wallComputer/STM32G4_PCB_V2/README.md

# STM32G4_PCB_V2
 Breakout Board for STM32G431CBU6
