wallComputer/STM32G4_PCB_V2/projectLibs/crystal_3215_STEP/NX3215SA.step

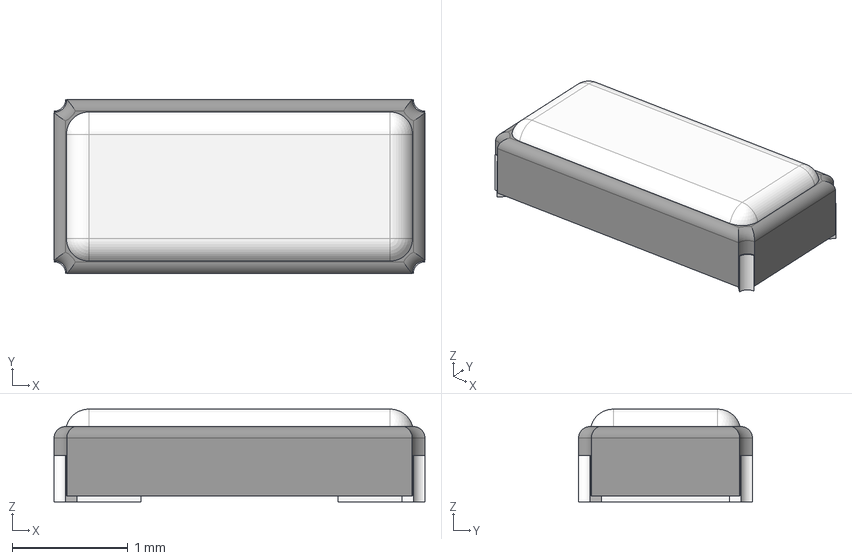
[picture p1: CAD file, 2022-04-19]
projectLibs/crystal_3215_STEP/NX3215SA.step
3.20 x 1.50 x 0.8 mm
