wallComputer/STM32G4_PCB_V2/projectLibs/TS-1187A-B-A-B/TS-1187A-B-A-B--3DModel-STEP-56544.STEP

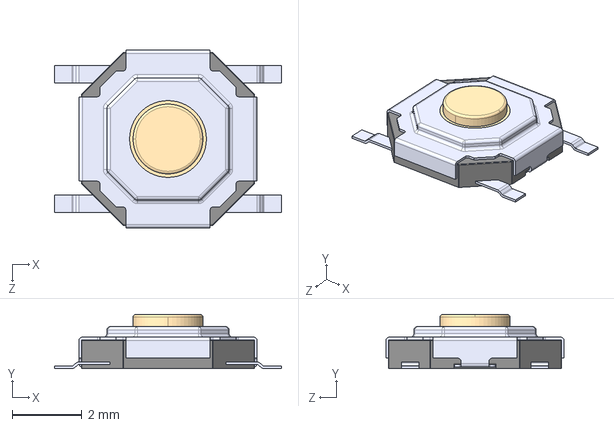
[picture p2: CAD file, 2022-04-19]
projectLibs/TS-1187A-B-A-B/TS-1187A-B-A-B--3DModel-STEP-56544.STEP
6.50 x 1.55 x 5.10 mm
