wallComputer/STM32G4_PCB_V2/projectLibs/TYPE-C-31-M-12/TYPE-C-31-M-12.step

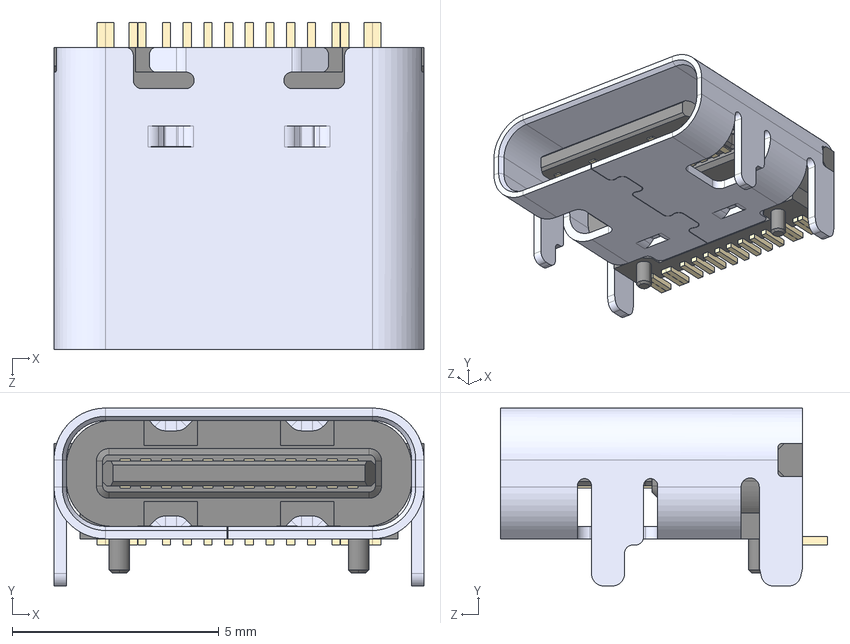
[picture p3: CAD file, 2022-04-19]
projectLibs/TYPE-C-31-M-12/TYPE-C-31-M-12.step
8.94 x 4.30 x 7.90 mm
