wallComputer/STM32G4_PCB_V2/projectLibs/ul_STM32G431CBU6/2022-04-16_14-02-51/STEP/UFQFPN-48_7X7X0P55MM.step

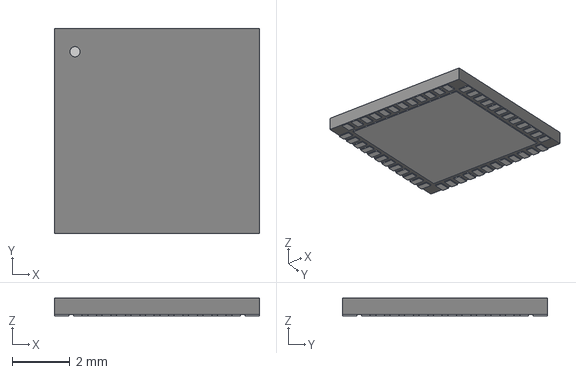
[picture p4: CAD file, 2022-04-19]
projectLibs/ul_STM32G431CBU6/2022-04-16_14-02-51/STEP/UFQFPN-48_7X7X0P55MM.step
7.11 x 7.11 x 0.612 mm
