wallComputer/STM32G4_PCB_V2/projectLibs/MOLEX_473460001/47346-0001.step

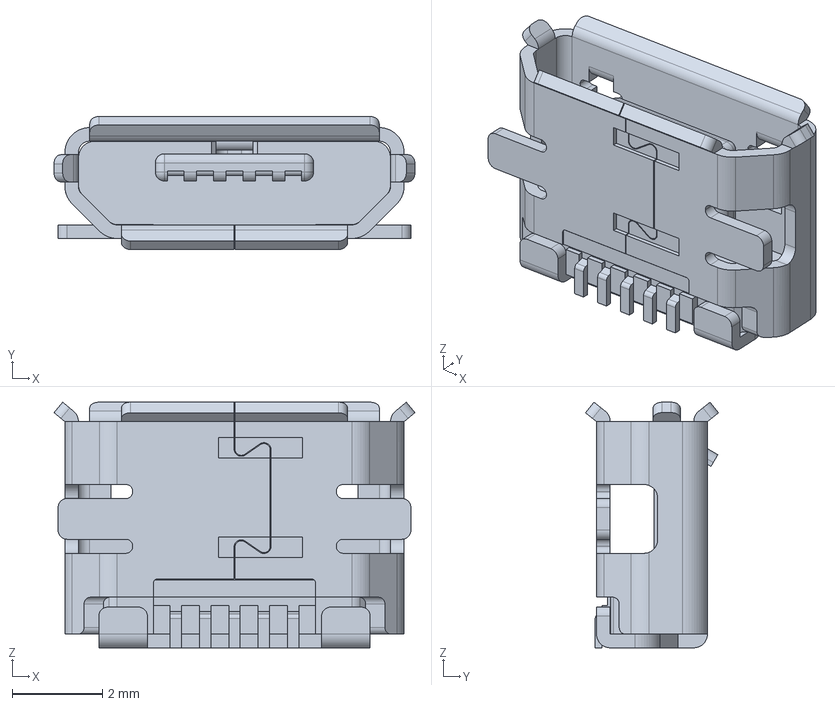
[picture p5: CAD file, 2022-04-19]
projectLibs/MOLEX_473460001/47346-0001.step
7.98 x 2.94 x 5.43 mm
