wallComputer/STM32G4_PCB_V2/STM32G4_PCB.pdf

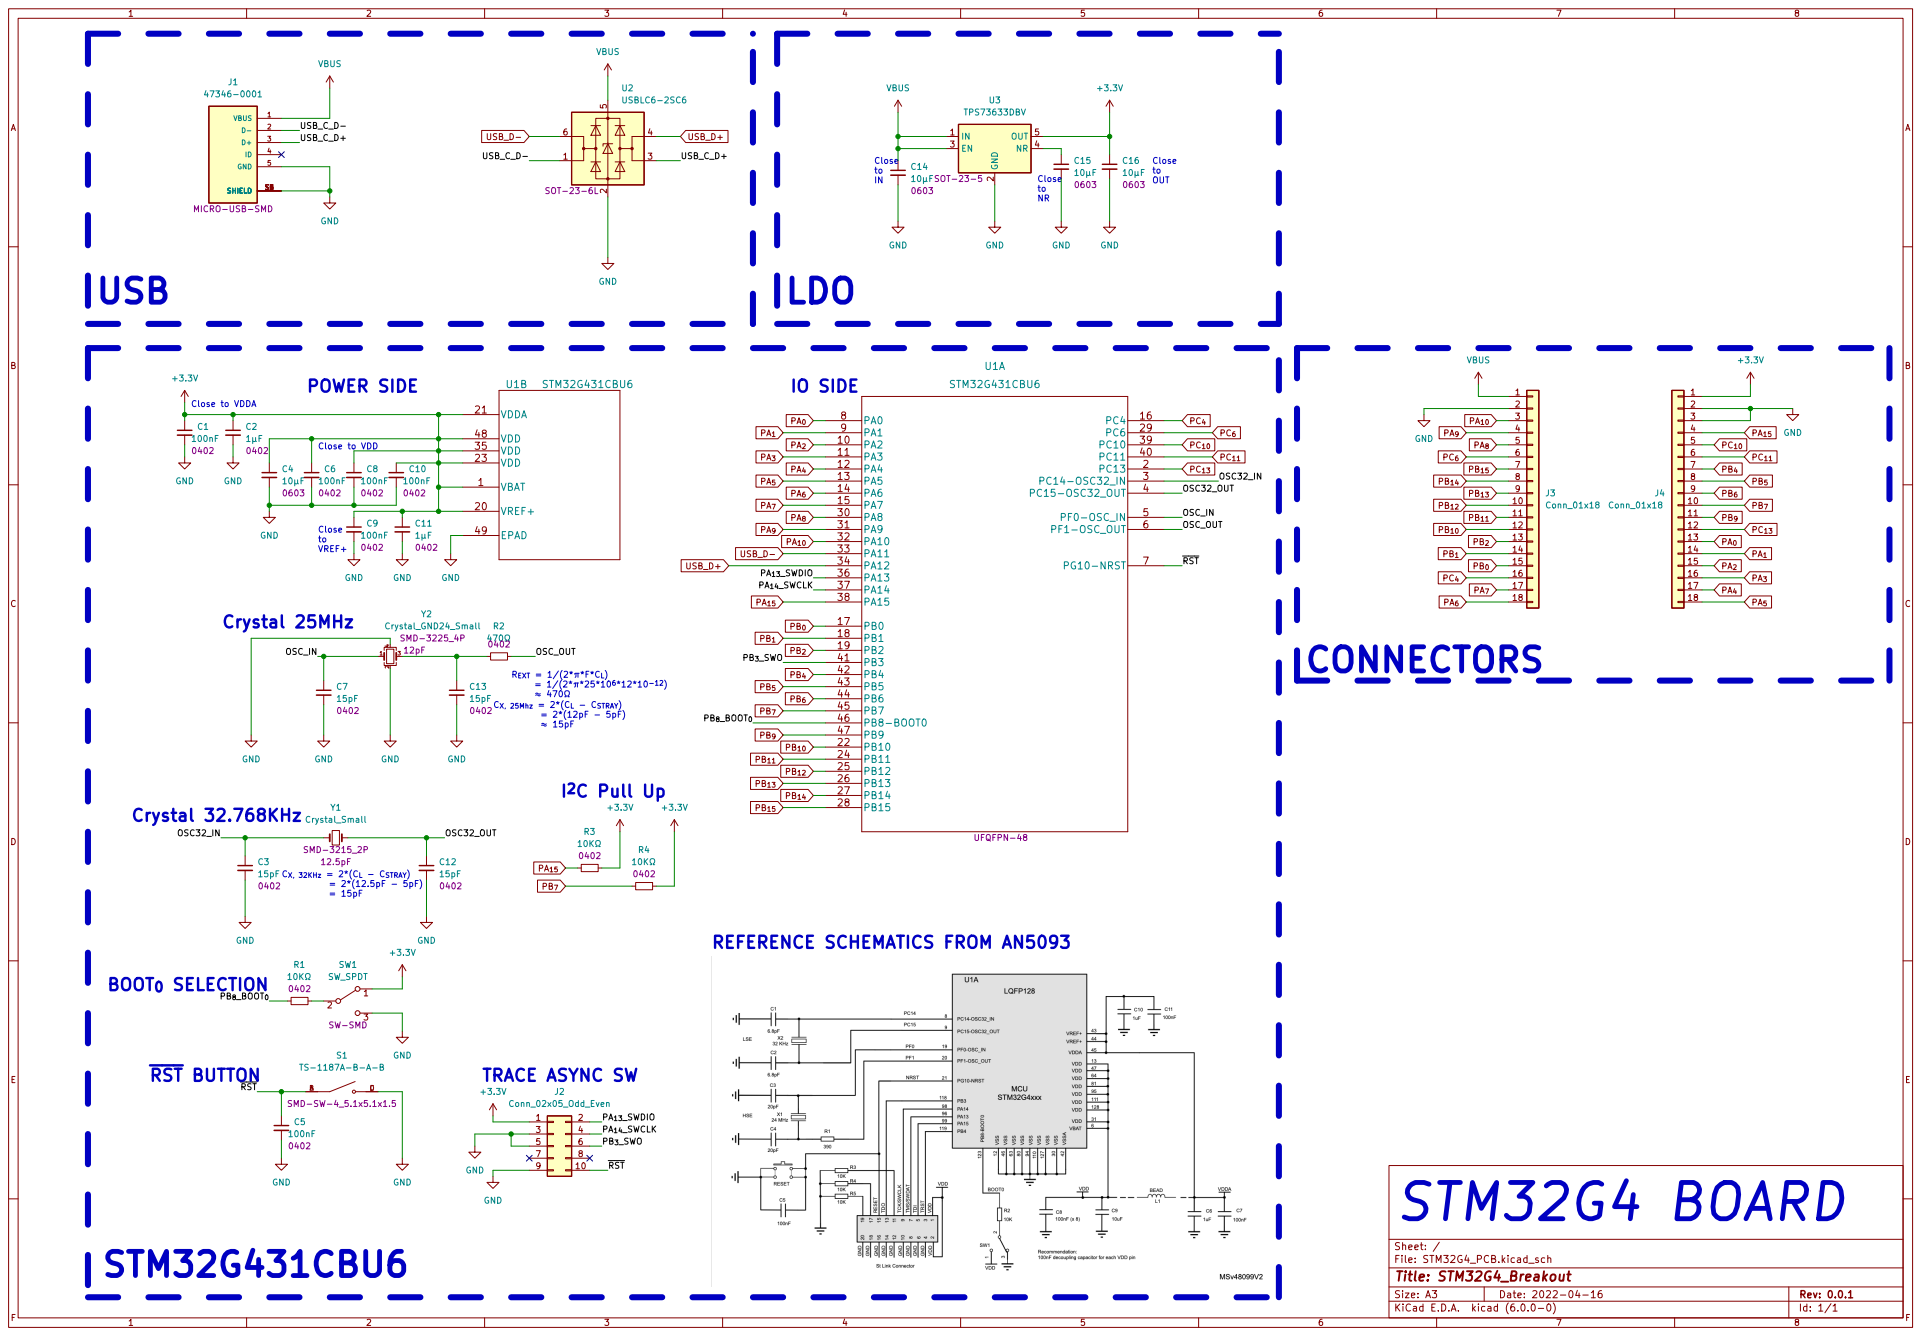
[picture p6: page 1]

toOUT Close to VDD
