wallComputer/STM32G4_PCB_V2/STM32G4_PCB.kicad_pcb

## KiCad design STM32G4_PCB.kicad_pcb (2022-04-19)

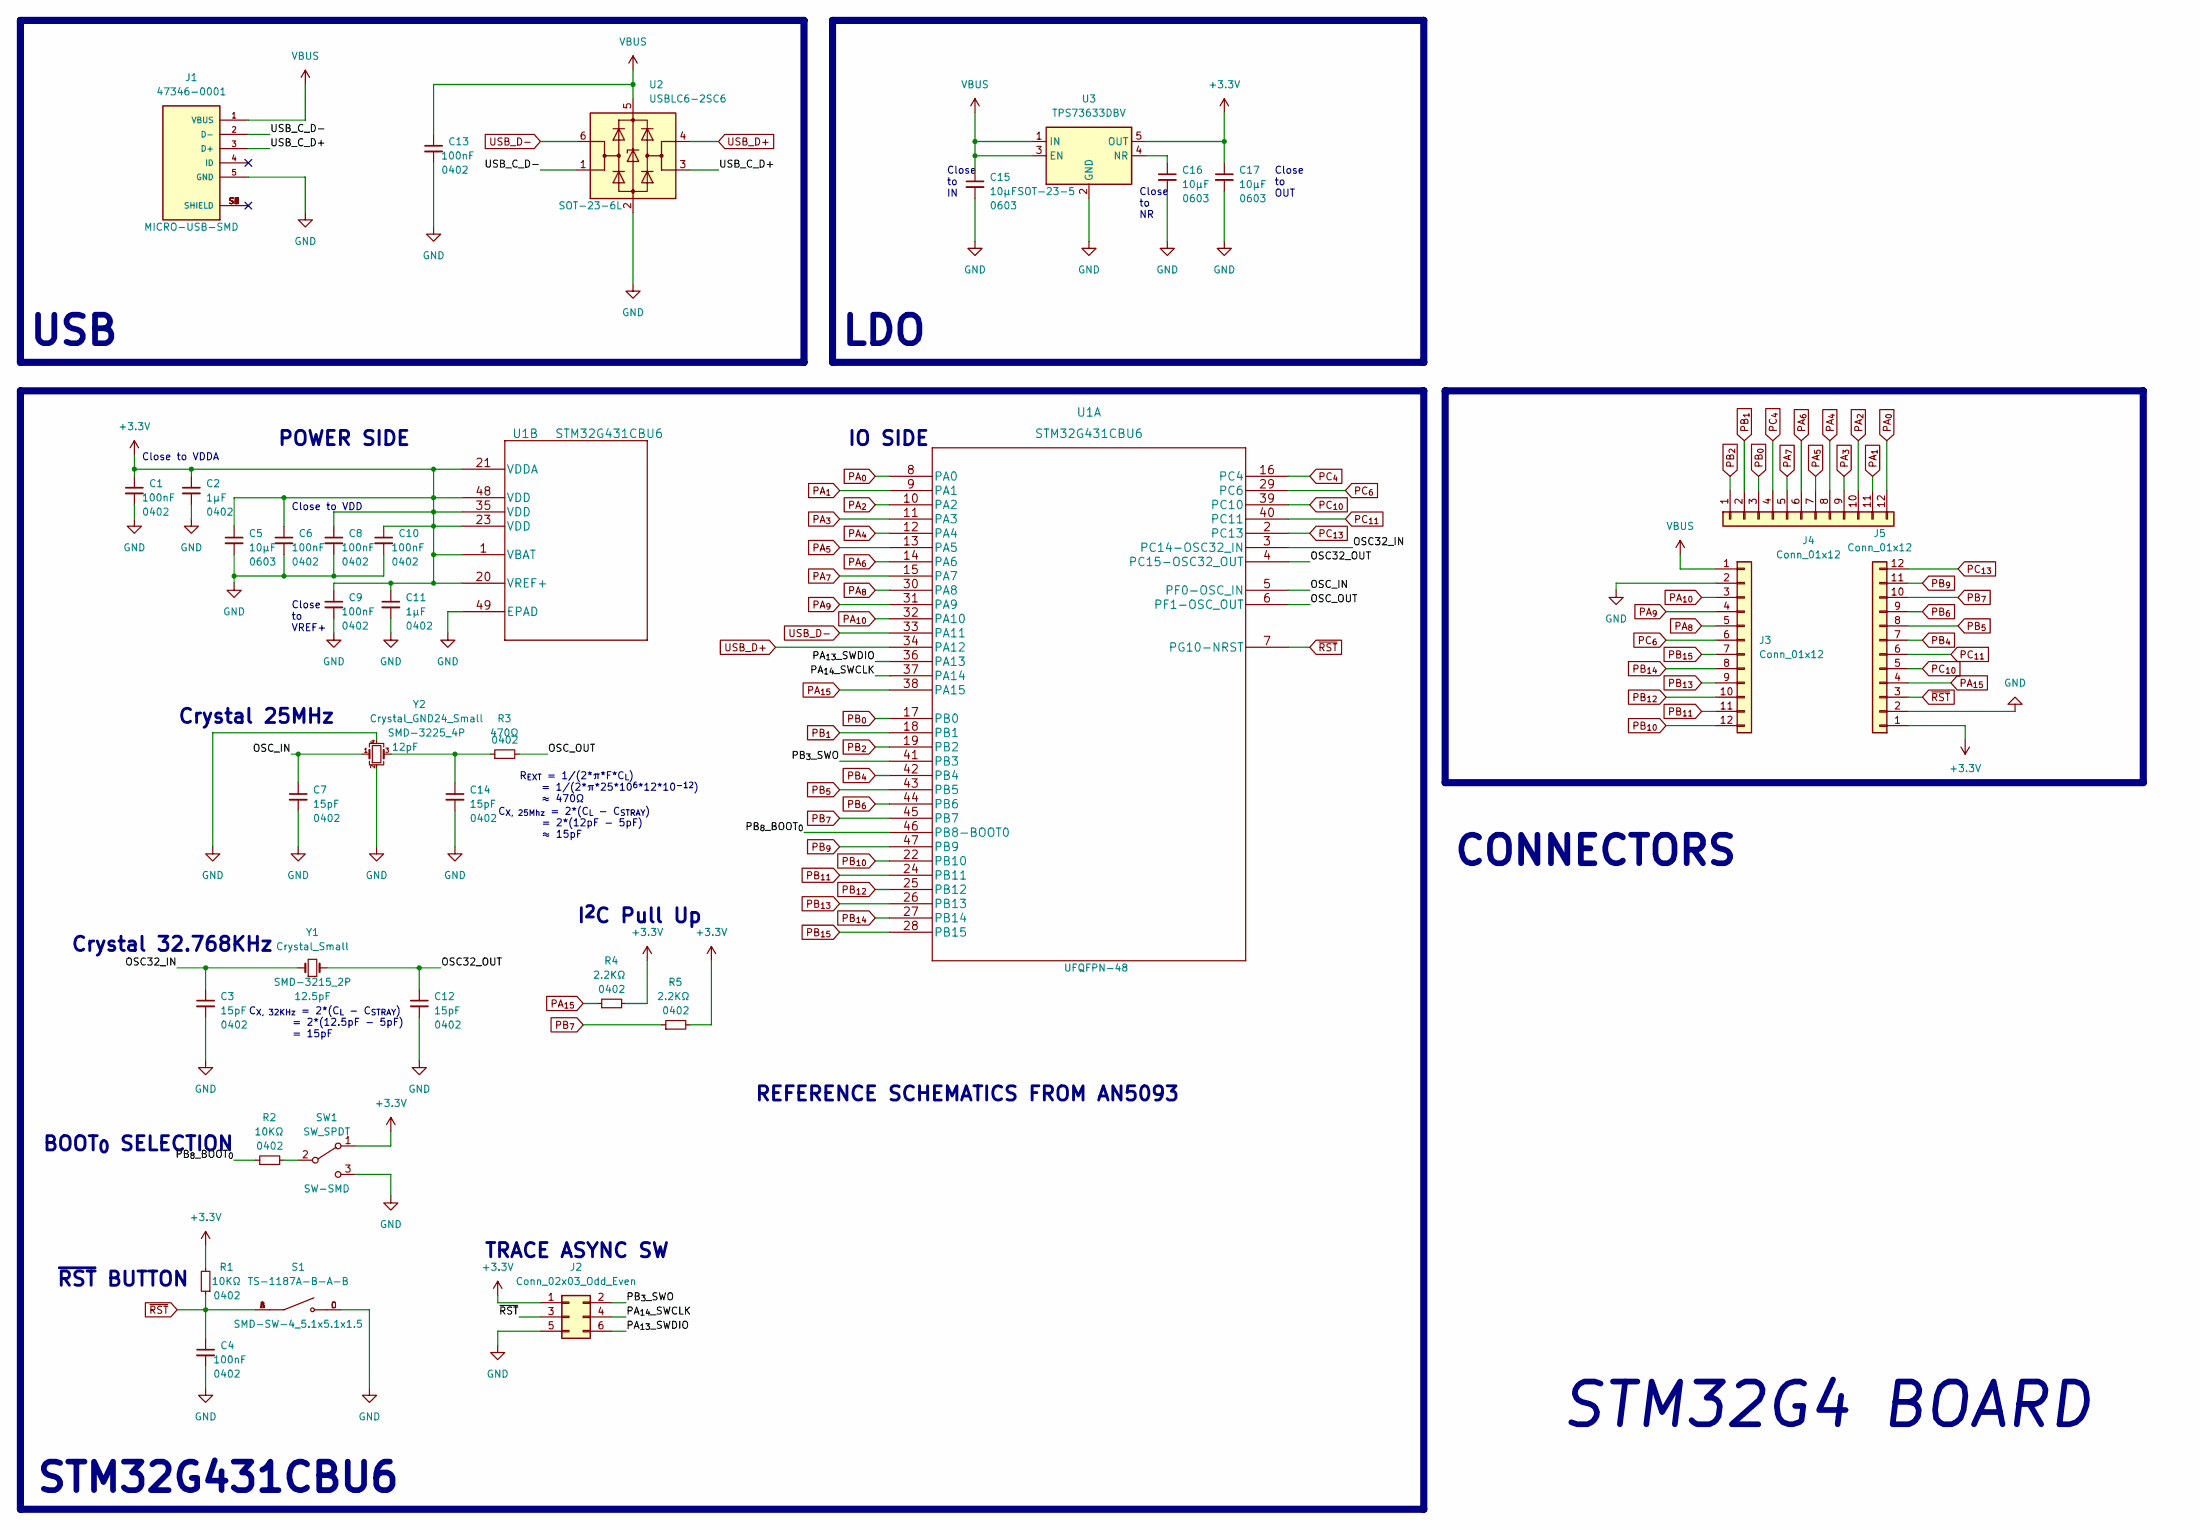
[picture p7: schematic STM32G4_PCB.kicad_sch, STM32G4_Breakout]

Parts:
C1, C4, C6, C8, C9, C10, C13: 100nF; C_0402_1005Metric; JLC 0402
C2, C11: 1µF; C_0402_1005Metric; JLC 0402
C3, C7, C12, C14: 15pF; C_0402_1005Metric; JLC 0402
C5, C15, C16, C17: 10µF; C_0603_1608Metric; JLC 0603
J1: 47346-0001; MOLEX_47346-0001; PARTREV E; JLC MICRO-USB-SMD
J2: Conn_02x03_Odd_Even; PinSocket_2x03_P2.54mm_Vertical
J3, J4, J5: Conn_01x12; PinHeader_1x12_P2.54mm_Vertical
R1, R2: 10KΩ; R_0402_1005Metric; JLC 0402
R3: 470Ω; R_0402_1005Metric; JLC 0402
R4, R5: 2.2KΩ; R_0402_1005Metric; JLC 0402
S1: TS-1187A-B-A-B; SW_TS-1187A-B-A-B; PARTREV A0; JLC SMD-SW-4_5.1x5.1x1.5
SW1: SW_SPDT; SW_SPDT_PCM12; JLC SW-SMD
U1: STM32G431CBU6; JLC UFQFPN-48
U2: USBLC6-2SC6; SOT-23-6; JLC SOT-23-6L
U3: TPS73633DBV; SOT-23-5; JLC SOT-23-5
Y1: Crystal_Small; Crystal_SMD_3215-2Pin_3.2x1.5mm; JLC SMD-3215_2P
Y2: Crystal_GND24_Small; Crystal_SMD_3225-4Pin_3.2x2.5mm; JLC SMD-3225_4P

Connections:
+3V3: C1.1, C2.1, C5.1, C6.1, C8.1, C9.1, C10.1, C11.1, C17.1, J2.1, J5.1, R1.2, R4.2, R5.2, SW1.1 (A), U1.1 (VBAT), U1.20 (VREF+), U1.21 (VDDA), U1.23 (VDD), U1.35 (VDD), U1.48 (VDD), U3.5 (OUT)
/OSC32_IN: C3.1, U1.3 (PC14-OSC32_IN), Y1.1
/OSC32_OUT: C12.1, U1.4 (PC15-OSC32_OUT), Y1.2
/OSC_IN: C7.1, U1.5 (PF0-OSC_IN), Y2.1
/OSC_OUT: R3.2, U1.6 (PF1-OSC_OUT)
/PA_{13}_SWDIO: J2.6, U1.36 (PA13)
/PA_{14}_SWCLK: J2.4, U1.37 (PA14)
/PB_{3}_SWO: J2.2, U1.41 (PB3)
/PB_{8}_BOOT_{0}: R2.1, U1.46 (PB8-BOOT0)
/USB_C_D+: J1.3 (D+), U2.3 (I/O2)
/USB_C_D-: J1.2 (D-), U2.1 (I/O1)
GND: C1.2, C2.2, C3.2, C4.2, C5.2, C6.2, C7.2, C8.2, C9.2, C10.2, C11.2, C12.2, C13.2, C14.2, C15.2, C16.2, C17.2, J1.5 (GND), J2.5, J3.2, J5.2, S1.C, S1.D, SW1.3 (C), U1.49 (EPAD), U2.2 (GND), U3.2 (GND), Y2.2, Y2.4
unnamed: C14.1, R3.1, Y2.3
unnamed: C16.1, U3.4 (NR)
unnamed: R2.2, SW1.2 (B)
PA_{0}: J4.12, U1.8 (PA0)
PA_{1}: J4.11, U1.9 (PA1)
PA_{2}: J4.10, U1.10 (PA2)
PA_{3}: J4.9, U1.11 (PA3)
PA_{4}: J4.8, U1.12 (PA4)
PA_{5}: J4.7, U1.13 (PA5)
PA_{6}: J4.6, U1.14 (PA6)
PA_{7}: J4.5, U1.15 (PA7)
PA_{8}: J3.5, U1.30 (PA8)
PA_{9}: J3.4, U1.31 (PA9)
PA_{10}: J3.3, U1.32 (PA10)
PA_{15}: J5.4, R4.1, U1.38 (PA15)
PB_{0}: J4.3, U1.17 (PB0)
PB_{1}: J4.2, U1.18 (PB1)
PB_{2}: J4.1, U1.19 (PB2)
PB_{4}: J5.7, U1.42 (PB4)
PB_{5}: J5.8, U1.43 (PB5)
PB_{6}: J5.9, U1.44 (PB6)
PB_{7}: J5.10, R5.1, U1.45 (PB7)
PB_{9}: J5.11, U1.47 (PB9)
PB_{10}: J3.12, U1.22 (PB10)
PB_{11}: J3.11, U1.24 (PB11)
PB_{12}: J3.10, U1.25 (PB12)
PB_{13}: J3.9, U1.26 (PB13)
PB_{14}: J3.8, U1.27 (PB14)
PB_{15}: J3.7, U1.28 (PB15)
PC_{4}: J4.4, U1.16 (PC4)
PC_{6}: J3.6, U1.29 (PC6)
PC_{10}: J5.5, U1.39 (PC10)
PC_{11}: J5.6, U1.40 (PC11)
PC_{13}: J5.12, U1.2 (PC13)
USB_D+: U1.34 (PA12), U2.4 (I/O2)
USB_D-: U1.33 (PA11), U2.6 (I/O1)
VBUS: C13.1, C15.1, J1.1 (VBUS), J3.1, U2.5 (VBUS), U3.1 (IN), U3.3 (EN)
~RST: C4.1, J2.3, J5.3, R1.1, S1.A, S1.B, U1.7 (PG10-NRST)

Notes on the sheet:
LDO
USB
C_{X, 25Mhz} = 2*(C_{L} - C_{STRAY}) = 2*(12pF - 5pF) ≈ 15pF
STM32G4 BOARD
IO SIDE
POWER SIDE
BOOT_{0} SELECTION
Close to NR
STM32G431CBU6
I^{2}C Pull Up
Close to VDDA
~{RST} BUTTON
CONNECTORS
Close to OUT
Crystal 25MHz
Close to VREF+
TRACE ASYNC SW
Close to VDD
Crystal 32.768KHz
Close to IN
R_{EXT} = 1/(2*π*F*C_{L}) = 1/(2*π*25*10^{6}*12*10^{-12}) ≈ 470Ω
REFERENCE SCHEMATICS FROM AN5093
C_{X, 32KHz} = 2*(C_{L} - C_{STRAY}) = 2*(12.5pF - 5pF) = 15pF

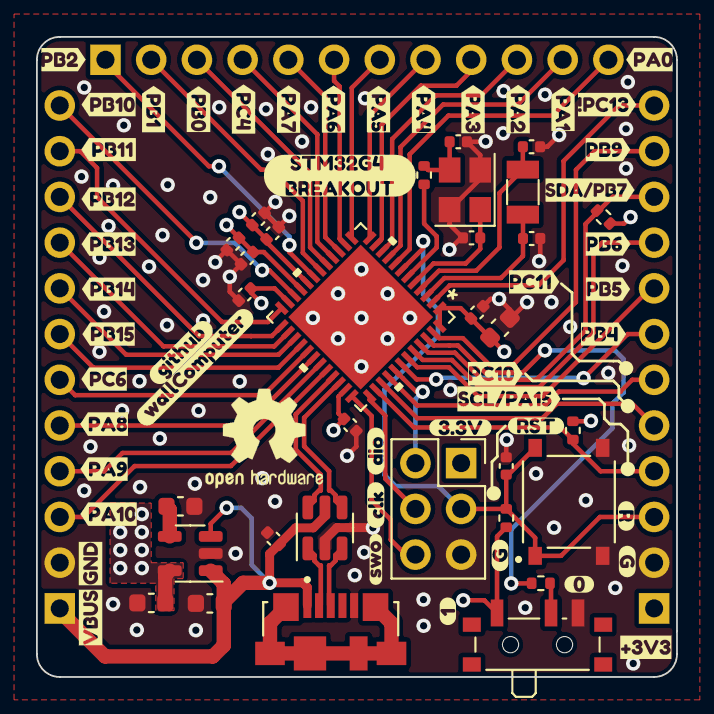
[picture p8: board STM32G4_PCB.kicad_pcb from above]

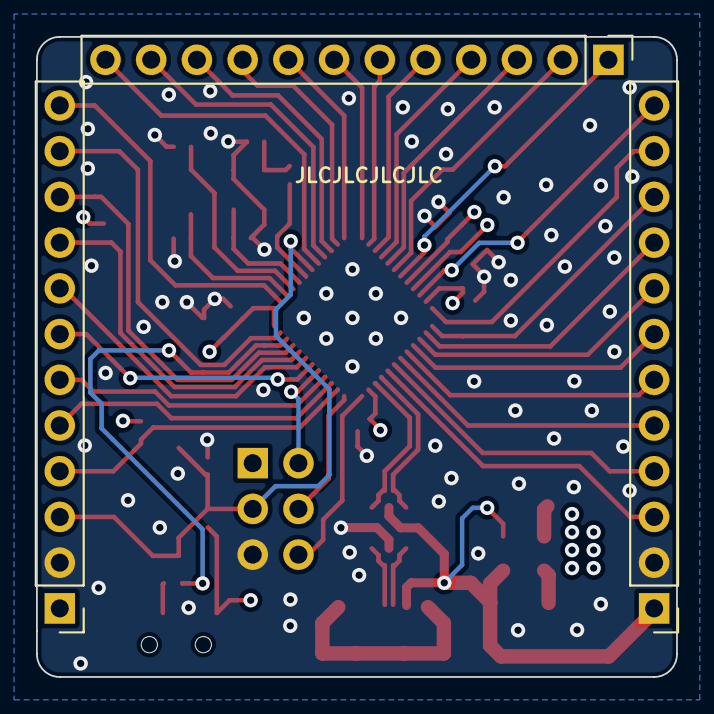
[picture p9: board STM32G4_PCB.kicad_pcb from below]

Board: 4 copper layers, 35.6 x 35.6 mm, 81 parts (3 on the bottom side), 50 nets.

Other parts of the board:
kibuzzard-625C2A9D: G***; kibuzzard-625C2A9D
kibuzzard-625C2AA9: G***; kibuzzard-625C2AA9
kibuzzard-625C2F2F: G***; kibuzzard-625C2F2F
kibuzzard-625C321F: G***; kibuzzard-625C321F
kibuzzard-625C332D: G***; kibuzzard-625C332D
kibuzzard-625C3253: G***; kibuzzard-625C3253
kibuzzard-625C3321: G***; kibuzzard-625C3321
kibuzzard-625C3326: G***; kibuzzard-625C3326
kibuzzard-625C3562: G***; kibuzzard-625C3562
kibuzzard-625EA97F: G***; kibuzzard-625EA97F
kibuzzard-625EA961: G***; kibuzzard-625EA961
kibuzzard-625EAB2F: G***; kibuzzard-625EAB2F
kibuzzard-625EAB9B: G***; kibuzzard-625EAB9B
kibuzzard-625EAB72: G***; kibuzzard-625EAB72
kibuzzard-625EAB92: G***; kibuzzard-625EAB92
kibuzzard-625EABA6: G***; kibuzzard-625EABA6
kibuzzard-625EABB3: G***; kibuzzard-625EABB3
kibuzzard-625EABC2: G***; kibuzzard-625EABC2
kibuzzard-625EABD7: G***; kibuzzard-625EABD7
kibuzzard-625EABEB: G***; kibuzzard-625EABEB
kibuzzard-625EAC54: G***; kibuzzard-625EAC54
kibuzzard-625EAC98: G***; kibuzzard-625EAC98
kibuzzard-625EACF4: G***; kibuzzard-625EACF4
kibuzzard-625EB0F6: G***; kibuzzard-625EB0F6
kibuzzard-625EB1FB: G***; kibuzzard-625EB1FB
kibuzzard-625EB2AC: G***; kibuzzard-625EB2AC
kibuzzard-625EB2BE: G***; kibuzzard-625EB2BE
kibuzzard-625EB3ED: G***; kibuzzard-625EB3ED
kibuzzard-625EB11D: G***; kibuzzard-625EB11D
kibuzzard-625EB17A: G***; kibuzzard-625EB17A
kibuzzard-625EB29C: G***; kibuzzard-625EB29C
kibuzzard-625EB36F: G***; kibuzzard-625EB36F
kibuzzard-625EB109: G***; kibuzzard-625EB109
kibuzzard-625EB131: G***; kibuzzard-625EB131
kibuzzard-625EB149: G***; kibuzzard-625EB149
kibuzzard-625EB164: G***; kibuzzard-625EB164
kibuzzard-625EB275: G***; kibuzzard-625EB275
kibuzzard-625EB353: G***; kibuzzard-625EB353
kibuzzard-625EDF71, kibuzzard-625EDF71#2: G***; kibuzzard-625EDF71
kibuzzard-625EF5DE: G***; kibuzzard-625EF5DE
kibuzzard-625EF7B7: G***; kibuzzard-625EF7B7
kibuzzard-625EF74A: G***; kibuzzard-625EF74A
kibuzzard-625EF765: G***; kibuzzard-625EF765
kibuzzard-625F2D40: G***; kibuzzard-625F2D40
kibuzzard-625F32F4: G***; kibuzzard-625F32F4
kibuzzard-625F331C: G***; kibuzzard-625F331C
