wallComputer/STM32G4_PCB_V2/projectLibs/ul_STM32G431CBU6/PartGuideLines.png

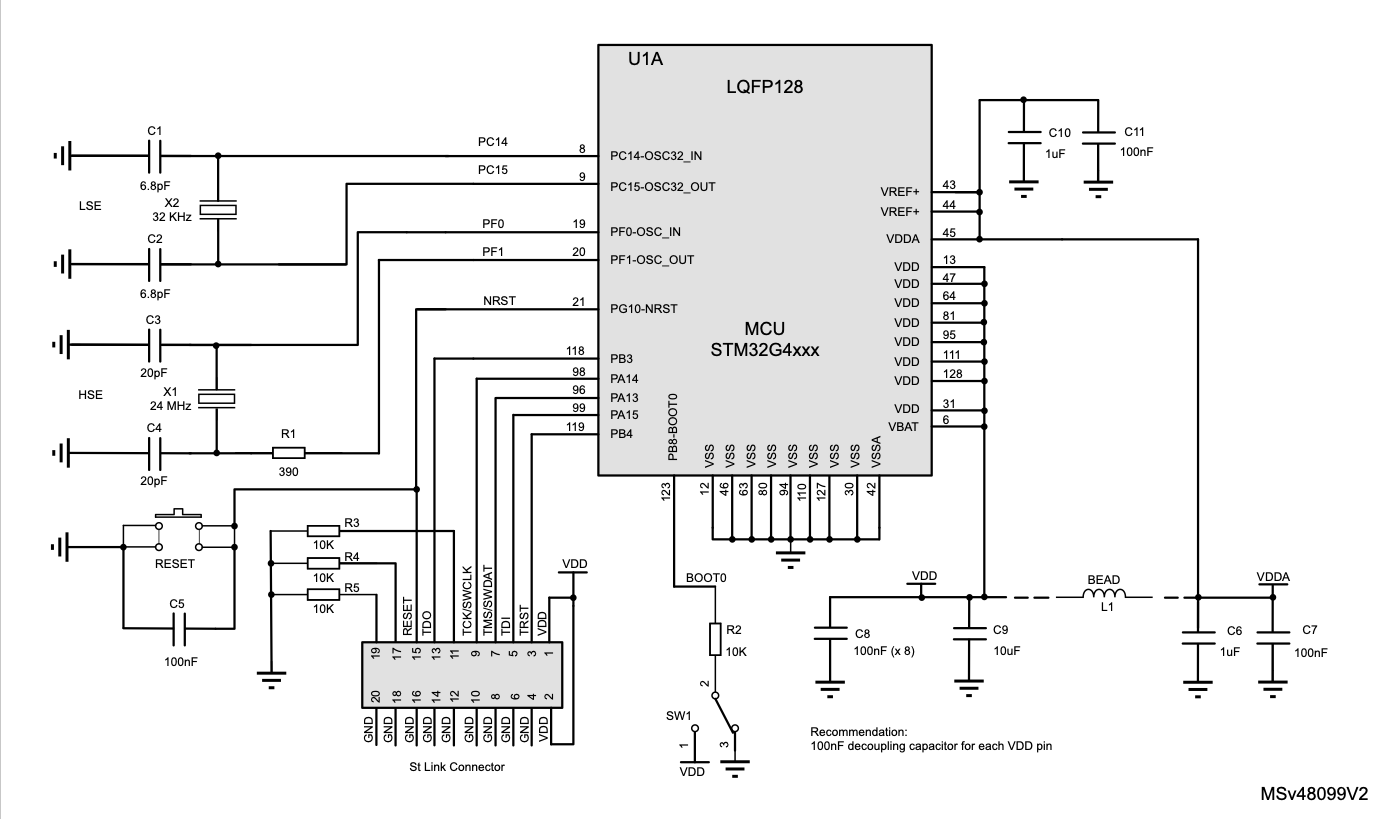
projectLibs/ul_STM32G431CBU6/PartGuideLines.png
