wallComputer/STM32G4_PCB_V2/(commit log)

2022-04-19 Delete STM32G4_PCB-backups directory
    Removed backups
2022-04-19 Delete STM32G4_PCB.round-tracks-config
    Remove experimental file
2022-04-19 Delete _autosave-STM32G4_PCB.kicad_sch
    Delete autosave file
